Robcib-GIT/Pioneer/3d_files/README.md

# 3D Files

This folder contains 3D models and G-code files for the Pioneer robot project.

## Usage

1. **SeparadoresDriver.stl**: print this file to create spacers that will separate the driver from the base.
2. **Base.stl**: use this file as a reference for the base of the robot, which is made from acrylic for placing the components of the robot.
3. **bateria_pioneer_0.4n_0.2mm_PLA_MK4IS_3h21m.gcode**: Use this G-code file to print the battery case on a Prusa MK4 3D printer with the specified settings.
