Robcib-GIT/Pioneer/3d_files/SeparadoresDriver.stl

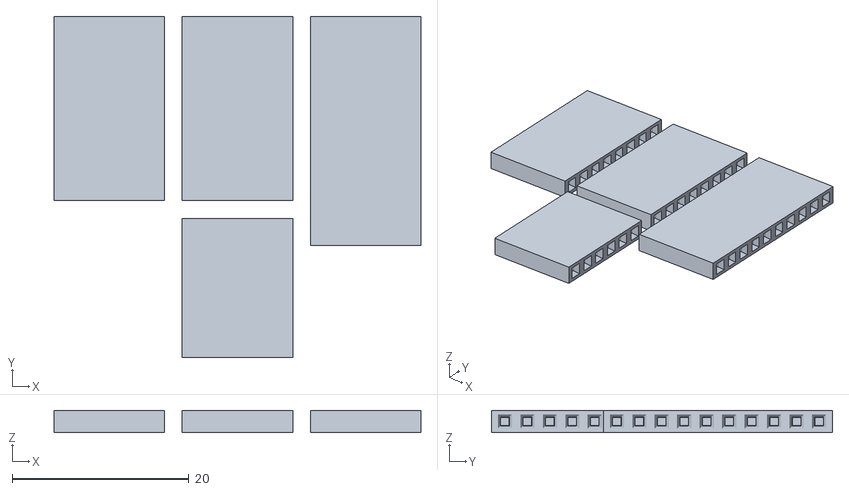
[picture p2: CAD file, 2025-02-01]
3d_files/SeparadoresDriver.stl
41.5 x 38.6 x 2.50
