Robcib-GIT/Pioneer/3d_files/Base.stl

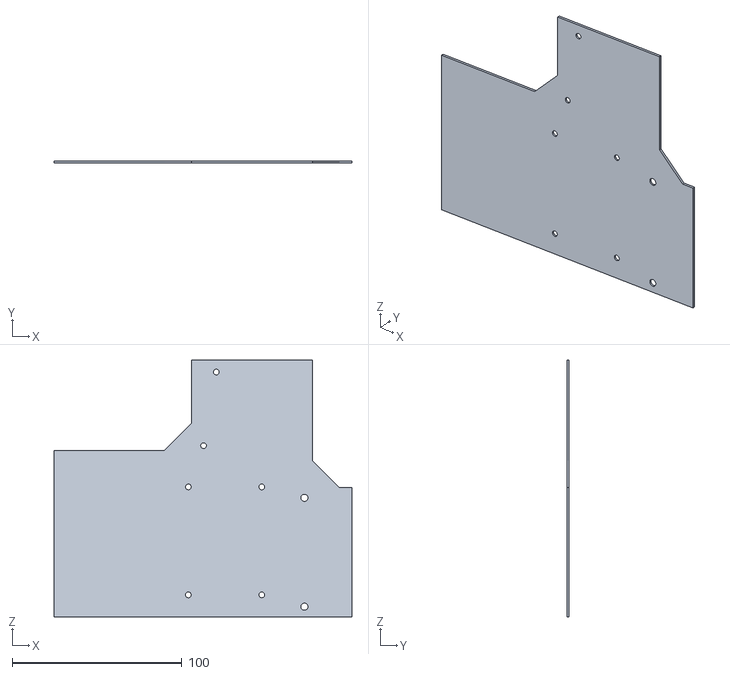
[picture p3: CAD file, 2025-02-01]
3d_files/Base.stl
175.3 x 1.40 x 151.0
