Robcib-GIT/Pioneer/pcb_design/RedLeaderSchematic.pdf

A

A

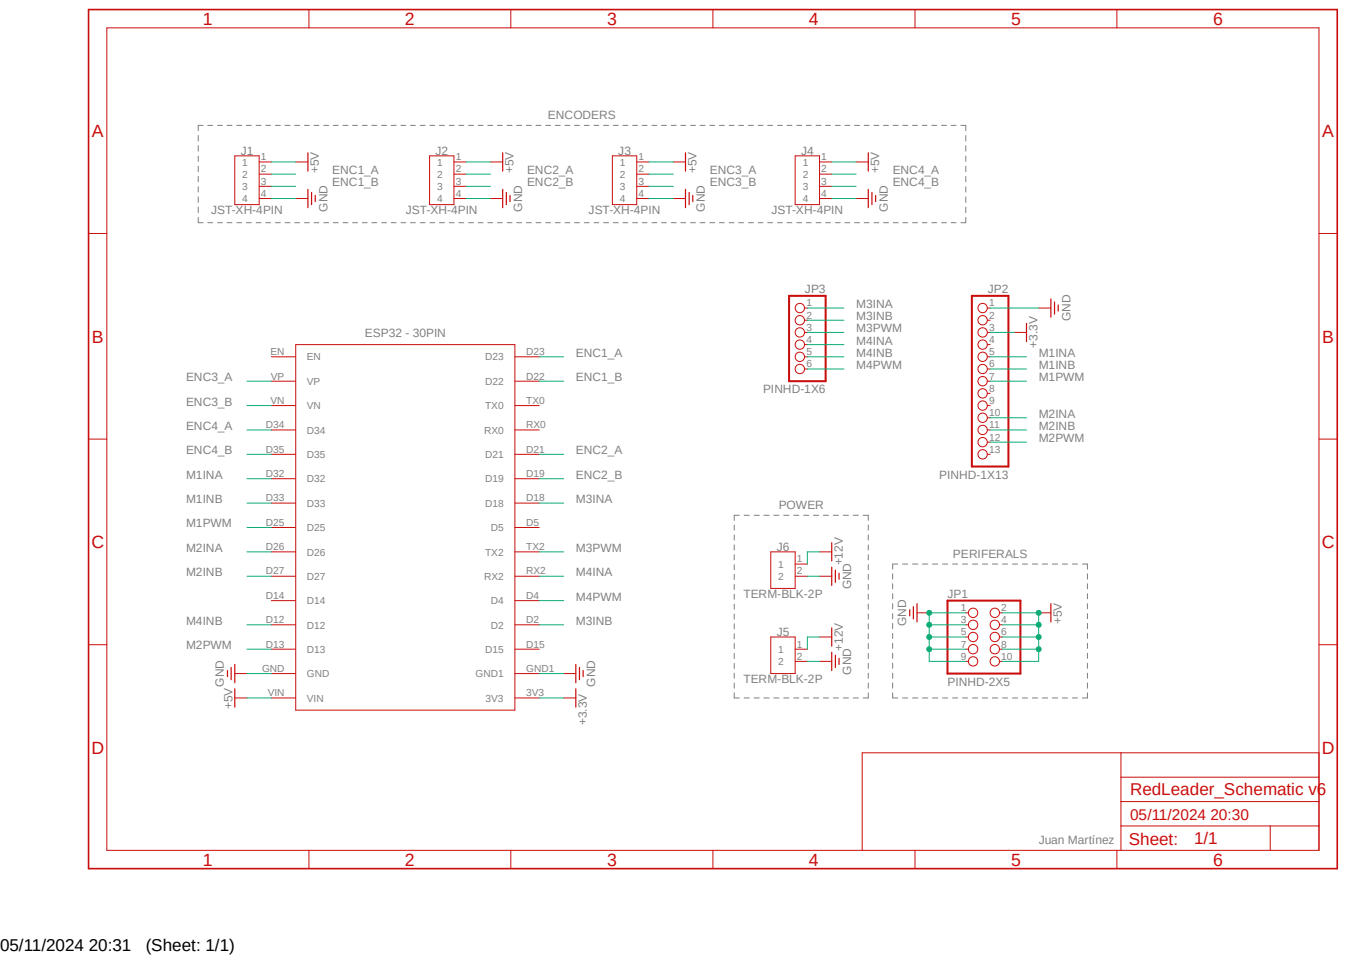
[picture p4: page 1]

Juan Martínez

Sheet: 1/1
