Robcib-GIT/Pioneer/legacy/pcb_old/PioneerSchematic.pdf

A

A

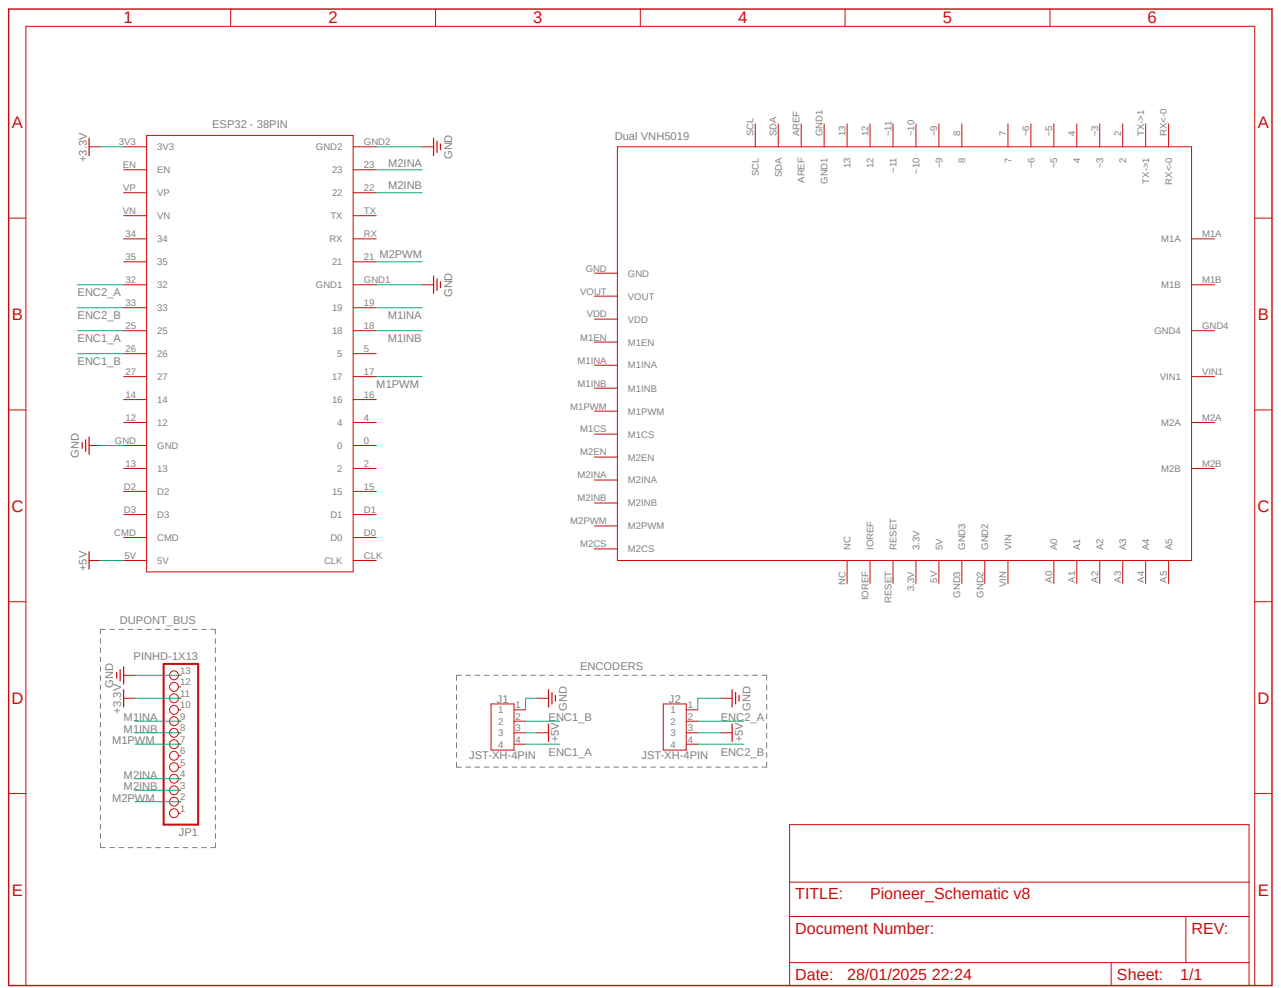
[picture p5: page 1]
ENCODERS; DUPONT_BUS; JST-XH-4PIN; JST-XH-4PIN ⁺⁵V GND; GND GND GND ⁺³.3V; PINHD-1X13; GND +5V; GND GND; GND1; GND2; CMD CMD; CLK; CLK 5V 5V; ESP32 - 38PIN; VOUT VOUT; VDD VDD; M1INA M1INA; M1INB M1INB; M1PWM M1PWM; M2INA M2INA; M2INB M2INB; M2PWM M2PWM; GND4; VIN1; Dual VNH5019; ENC1_A; ENC1_B; ENC2_B; ENC2_A; M2INA; M2INB; M2PWM; M1INA; M1INB; M1PWM; Pioneer_Schematic v8; TITLE:

8 ~9 ~9 ~10 ~10 ~11 ~11 12 12 13 13 GND1 GND1 AREF AREF SDA SDA SCL SCL A5 A5 A4 A4 A3 A3 A2 A2 A1 A1 A0 A0 VIN VIN GND2 GND2 GND3 GND3 5V 5V 3.3V 3.3V RESET RESET IOREF IOREF NC NC

Document Number: | REV:

Date: 28/01/2025 22:24 | Sheet: 1/1
