Robcib-GIT/Pioneer/(commit log)

2024-09-09 Added motor driver documentation
2024-09-10 Added motorTest project
2024-09-10 Added encoderCount project
2024-09-10 Added encoderPID project
2024-09-23 Fix typo in comment
    [main.ino]
2025-01-28 Added PCB files
    [copper_bottom.gbr, copper_top.gbr, drill_1_16.xln, gerber_job.gbrjob, profile.gbr, silkscreen_bottom.gbr, silkscreen_top.gbr, soldermask_bottom.gbr]
2025-01-28 Revert "Merge branch 'main' of https://github.com/jmkaz16/Pioneer"
    This reverts commit 79188579fcaca4941d4009c4fb44d99895c25435, reversing
    changes made to 4bc92e6dfad558a2206e903669ed84f25b03182a.
    [main.cpp, microROS.cpp, microROS.h, pioneer_ros1.ino]
2025-01-28 Updated pcb files
    [copper_bottom.gbr, copper_top.gbr, drill_1_16.xln, gerber_job.gbrjob, profile.gbr, silkscreen_top.gbr, soldermask_bottom.gbr, soldermask_top.gbr]
2025-01-28 Added legacy pcb files
    [copper_bottom.gbr, copper_top.gbr, drill_1_16.xln, gerber_job.gbrjob, profile.gbr, silkscreen_bottom.gbr, silkscreen_top.gbr, soldermask_bottom.gbr]
2025-01-28 Rearranged files
    [copper_bottom.gbr, copper_top.gbr, drill_1_16.xln, gerber_job.gbrjob, profile.gbr, silkscreen_bottom.gbr, silkscreen_top.gbr, soldermask_bottom.gbr]
2025-01-29 Renamed folder
    [copper_bottom.gbr, copper_top.gbr, drill_1_16.xln, gerber_job.gbrjob, profile.gbr, silkscreen_bottom.gbr, silkscreen_top.gbr, soldermask_bottom.gbr]
2025-01-29 Updated pin configuration
2025-02-01 Add 3d files
    [Base.stl, SeparadoresDriver.stl]
2025-02-01 Add PowerDiagram.
2025-02-01 Rearrange files
    [copper_bottom.gbr, copper_top.gbr, drill_1_16.xln, gerber_job.gbrjob, profile.gbr, silkscreen_bottom.gbr, silkscreen_top.gbr, soldermask_bottom.gbr]
